im-pro-at/DIYPOV/README.md

# DIYPOV
 One POV Display to rule them all!
