im-pro-at/DIYPOV/3D/ezgif-3-e1404efcaa7f.gif

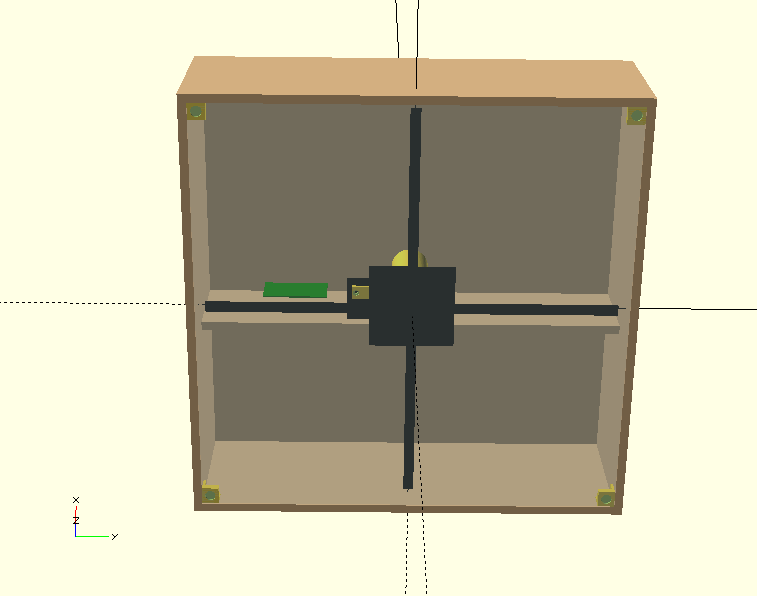
3D/ezgif-3-e1404efcaa7f.gif
