im-pro-at/DIYPOV/3D/drill_wood_500_100.pdf

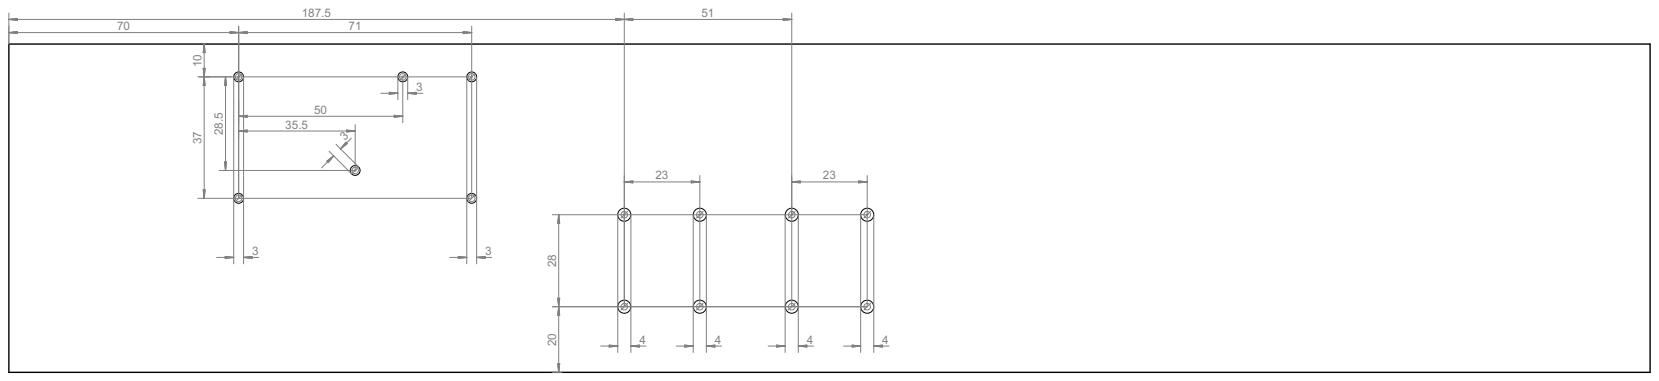
[picture p2: page 1]
