im-pro-at/DIYPOV/3D/drill_wood_500_500.pdf

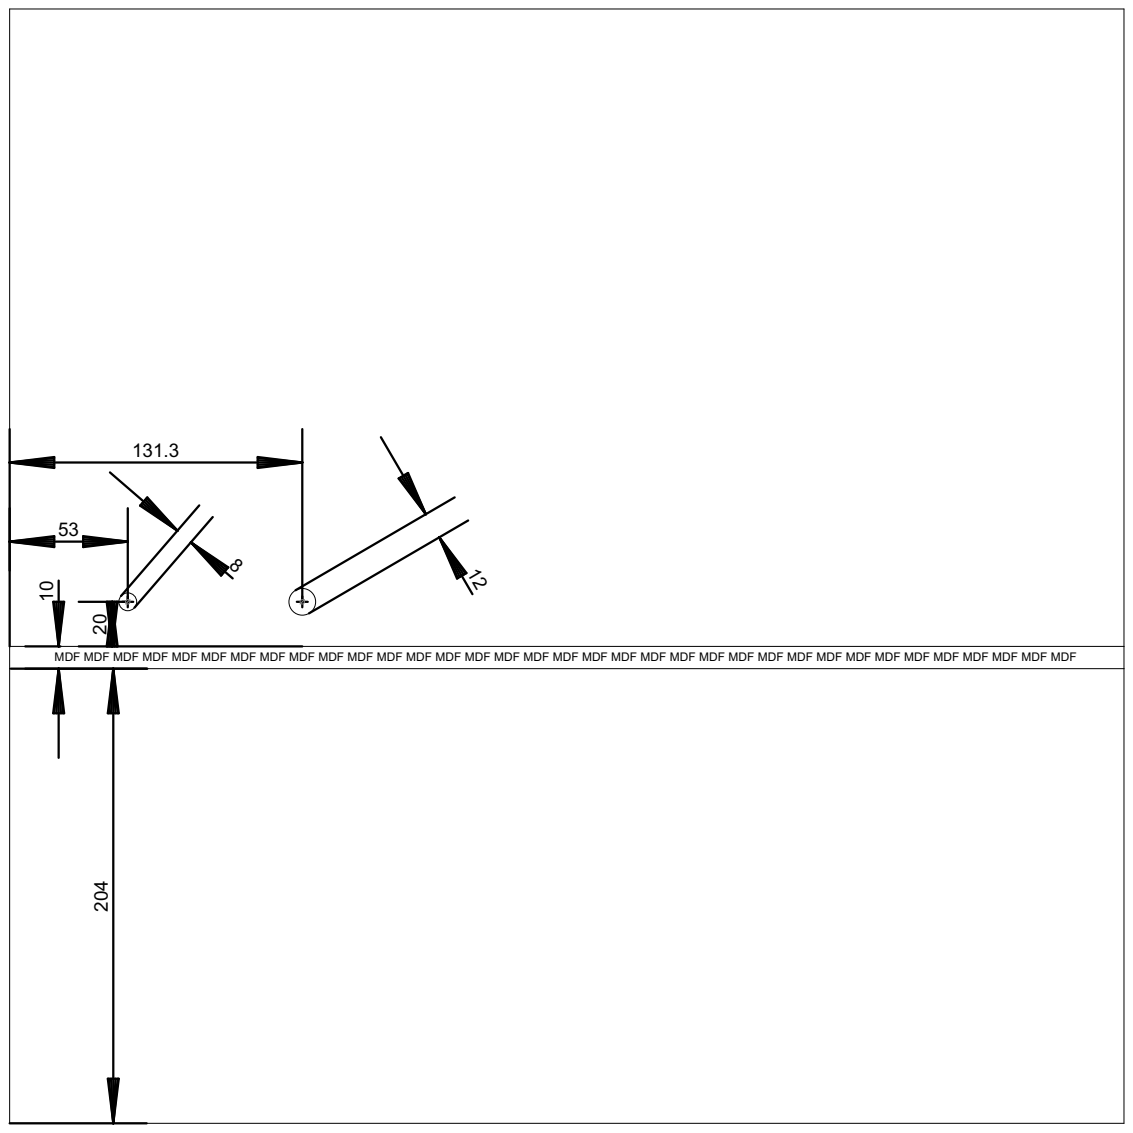
[picture p4: page 1]

MDF MDF MDF MDF MDF MDF MDF MDF MDF MDF MDF MDF MDF MDF MDF MDF MDF MDF MDF MDF MDF MDF MDF MDF MDF MDF MDF MDF MDF MDF MDF MDF MDF MDF MDF
