im-pro-at/DIYPOV/pcb/motor.brd

## EAGLE design pcb/motor.brd (2019-09-08)

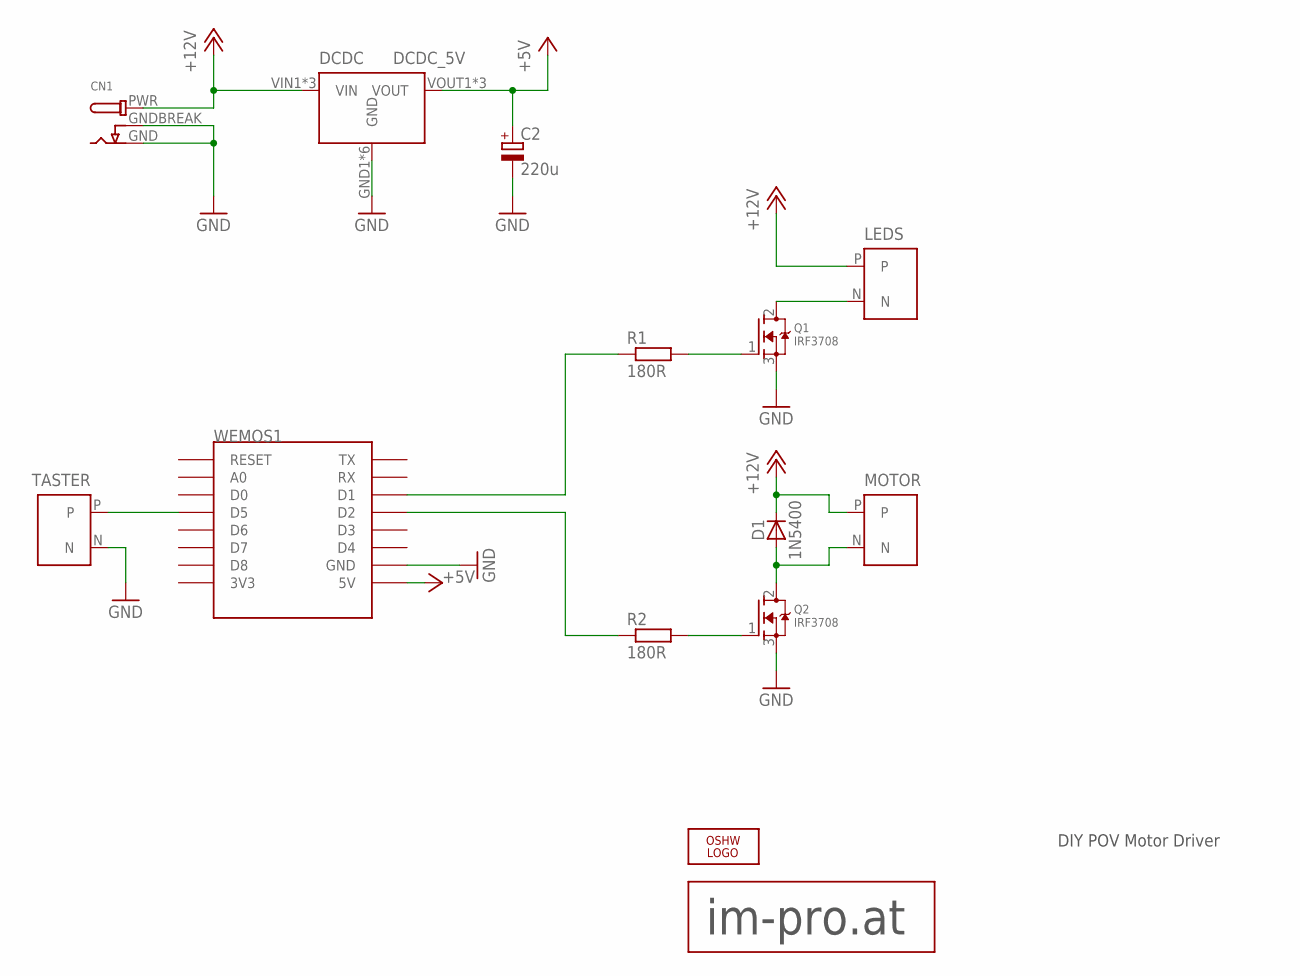
[picture p5: schematic motor.sch]

Parts:
C2: 220u; E3,5-8
CN1: DCBARRELPTH; DCJACK_2MM_PTH
D1: 1N5400; DO201-15
DCDC: DCDC_5V; DCDC
LEDS: TX30; XT30
LOGO1: OSHW_LOGO_FILLX0350-NT; OSHW_FILLX350_NOTEXT
MOTOR: TX30; XT30
Q1, Q2: IRF3708; TO220V
R1, R2: 180R; 0207/10
TASTER: TX30; XT30
U$1: LOGO20MM; LOGO_20MM
WEMOS1: WEMOS-D1-MINI

Connections:
+5V: C2.+, DCDC.VOUT1 (VOUT), DCDC.VOUT2 (VOUT), DCDC.VOUT3 (VOUT), WEMOS1.5V
+12V: CN1.PWR, D1.C, DCDC.VIN1 (VIN), DCDC.VIN2 (VIN), DCDC.VIN3 (VIN), LEDS.P, MOTOR.P
GND: C2.-, CN1.GND, CN1.GNDBREAK, DCDC.GND1 (GND), DCDC.GND2 (GND), DCDC.GND3 (GND), DCDC.GND4 (GND), DCDC.GND5 (GND), DCDC.GND6 (GND), Q1.3 (S), Q2.3 (S), TASTER.N, WEMOS1.GND
unnamed: D1.A, MOTOR.N, Q2.2 (D)
unnamed: LEDS.N, Q1.2 (D)
unnamed: R1.1, WEMOS1.D1
unnamed: TASTER.P, WEMOS1.D5
unnamed: R2.1, WEMOS1.D2
unnamed: Q2.1 (G), R2.2
unnamed: Q1.1 (G), R1.2

Notes on the sheet:
DIY POV Motor Driver

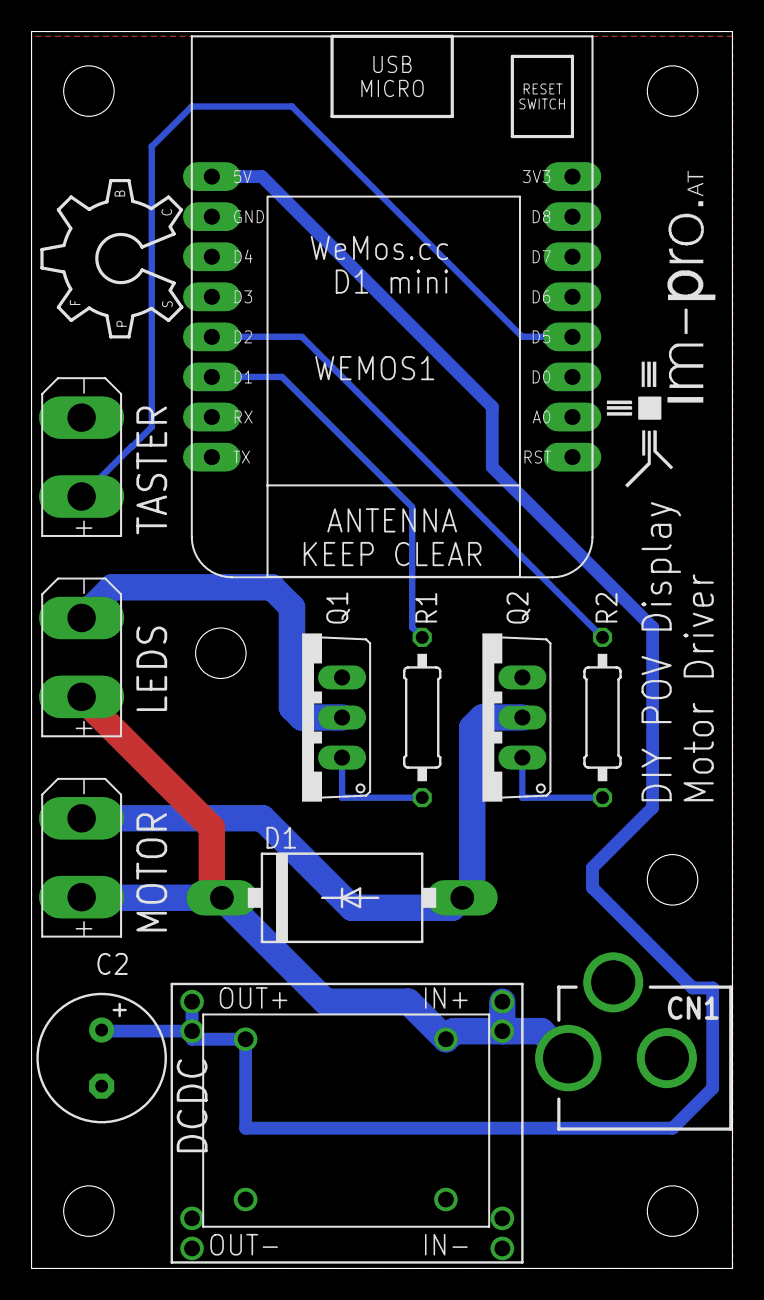
[picture p6: board motor.brd from above]

Board: 2 copper layers, 44.4 x 78.4 mm, 14 parts (0 on the bottom side), 10 nets.
