im-pro-at/DIYPOV/pcb/main.brd

## EAGLE design pcb/main.brd (2019-09-08)

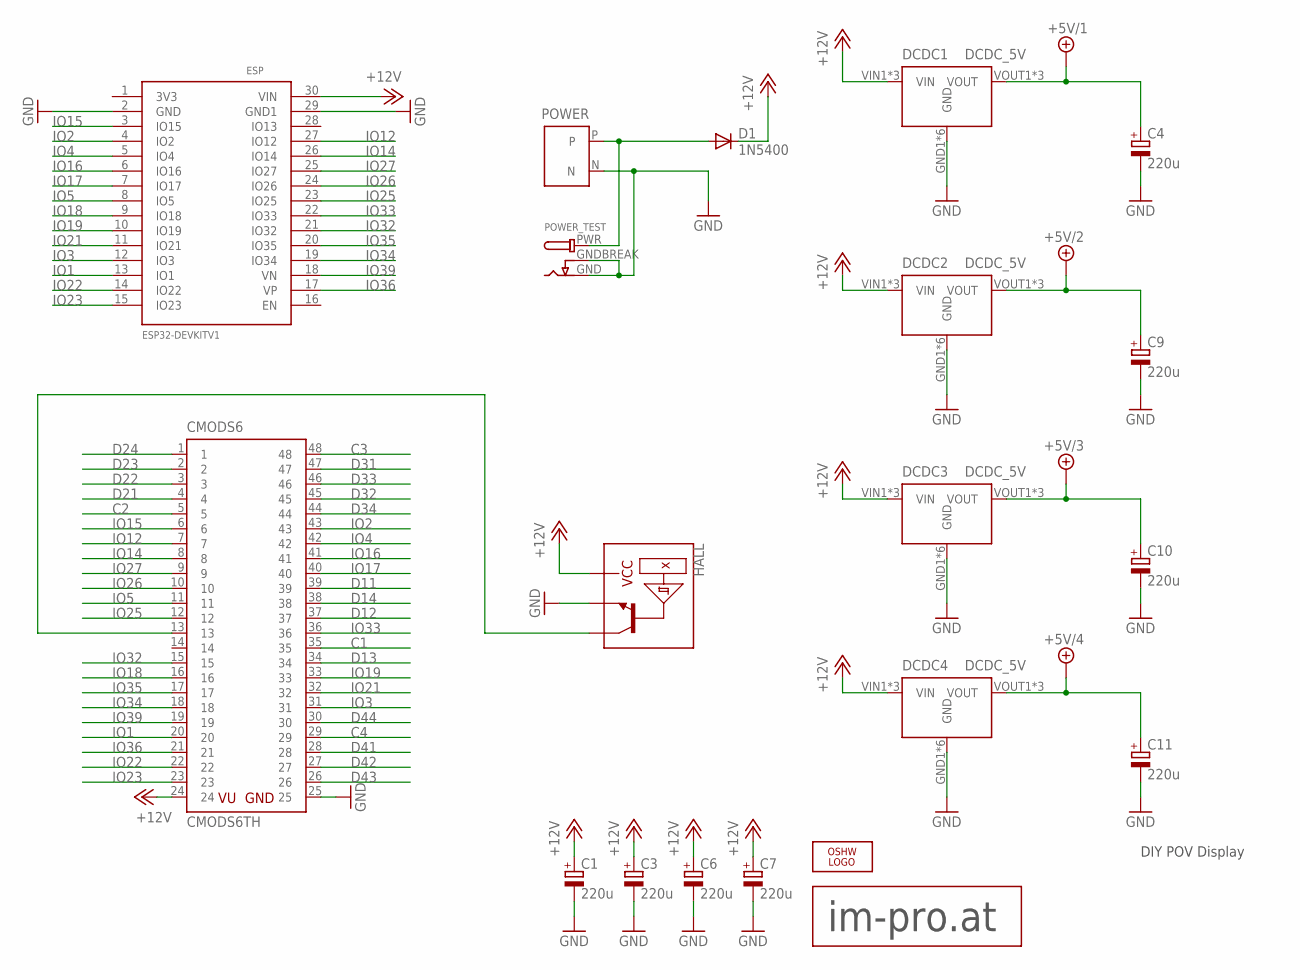
[picture p7: schematic main.sch, sheet 1]

Parts:
C1, C3, C4, C6, C7, C9, C10, C11: 220u; E3,5-8
CMODS6: CMODS6TH; DIL48
D1: 1N5400; DO201-15
DCDC1, DCDC2, DCDC3, DCDC4: DCDC_5V; DCDC
ESP: ESP32DEVKITV1; ESP32-DEVKITV1
HALL: HALL
LOGO1: OSHW_LOGO_FILLX0350-NT; OSHW_FILLX350_NOTEXT
POWER: TX30; XT30
POWER_TEST: DCBARRELPTH; DCJACK_2MM_PTH
U$2: LOGO20MM; LOGO_20MM

Connections:
+5V/1: C4.+, DCDC1.VOUT1 (VOUT), DCDC1.VOUT2 (VOUT), DCDC1.VOUT3 (VOUT); also elsewhere on the board
+5V/2: C9.+, DCDC2.VOUT1 (VOUT), DCDC2.VOUT2 (VOUT), DCDC2.VOUT3 (VOUT); also elsewhere on the board
+5V/3: C10.+, DCDC3.VOUT1 (VOUT), DCDC3.VOUT2 (VOUT), DCDC3.VOUT3 (VOUT); also elsewhere on the board
+5V/4: C11.+, DCDC4.VOUT1 (VOUT), DCDC4.VOUT2 (VOUT), DCDC4.VOUT3 (VOUT); also elsewhere on the board
+12V: C1.+, C3.+, C6.+, C7.+, CMODS6.24, D1.C, DCDC1.VIN1 (VIN), DCDC1.VIN2 (VIN), DCDC1.VIN3 (VIN), DCDC2.VIN1 (VIN), DCDC2.VIN2 (VIN), DCDC2.VIN3 (VIN), DCDC3.VIN1 (VIN), DCDC3.VIN2 (VIN), DCDC3.VIN3 (VIN), DCDC4.VIN1 (VIN), DCDC4.VIN2 (VIN), DCDC4.VIN3 (VIN), ESP.30 (VIN), HALL.VCC
C1: CMODS6.35; also elsewhere on the board
C2: CMODS6.5; also elsewhere on the board
C3: CMODS6.48; also elsewhere on the board
C4: CMODS6.29; also elsewhere on the board
D11: CMODS6.39; also elsewhere on the board
D12: CMODS6.37; also elsewhere on the board
D13: CMODS6.34; also elsewhere on the board
D14: CMODS6.38; also elsewhere on the board
D21: CMODS6.4; also elsewhere on the board
D22: CMODS6.3; also elsewhere on the board
D23: CMODS6.2; also elsewhere on the board
D24: CMODS6.1; also elsewhere on the board
D31: CMODS6.47; also elsewhere on the board
D32: CMODS6.45; also elsewhere on the board
D33: CMODS6.46; also elsewhere on the board
D34: CMODS6.44; also elsewhere on the board
D41: CMODS6.28; also elsewhere on the board
D42: CMODS6.27; also elsewhere on the board
D43: CMODS6.26; also elsewhere on the board
D44: CMODS6.30; also elsewhere on the board
GND: C1.-, C3.-, C4.-, C6.-, C7.-, C9.-, C10.-, C11.-, CMODS6.25, DCDC1.GND1 (GND), DCDC1.GND2 (GND), DCDC1.GND3 (GND), DCDC1.GND4 (GND), DCDC1.GND5 (GND), DCDC1.GND6 (GND), DCDC2.GND1 (GND), DCDC2.GND2 (GND), DCDC2.GND3 (GND), DCDC2.GND4 (GND), DCDC2.GND5 (GND), DCDC2.GND6 (GND), DCDC3.GND1 (GND), DCDC3.GND2 (GND), DCDC3.GND3 (GND), DCDC3.GND4 (GND), DCDC3.GND5 (GND), DCDC3.GND6 (GND), DCDC4.GND1 (GND), DCDC4.GND2 (GND), DCDC4.GND3 (GND), DCDC4.GND4 (GND), DCDC4.GND5 (GND), DCDC4.GND6 (GND), ESP.2 (GND), ESP.29 (GND1), HALL.GND, POWER.N, POWER_TEST.GND, POWER_TEST.GNDBREAK; also elsewhere on the board
IO1: CMODS6.20, ESP.13 (IO1)
IO2: CMODS6.43, ESP.4 (IO2)
IO3: CMODS6.31, ESP.12 (IO3)
IO4: CMODS6.42, ESP.5 (IO4)
IO5: CMODS6.11, ESP.8 (IO5)
IO12: CMODS6.7, ESP.27 (IO12)
IO14: CMODS6.8, ESP.26 (IO14)
IO15: CMODS6.6, ESP.3 (IO15)
IO16: CMODS6.41, ESP.6 (IO16)
IO17: CMODS6.40, ESP.7 (IO17)
IO18: CMODS6.16, ESP.9 (IO18)
IO19: CMODS6.33, ESP.10 (IO19)
IO21: CMODS6.32, ESP.11 (IO21)
IO22: CMODS6.22, ESP.14 (IO22)
IO23: CMODS6.23, ESP.15 (IO23)
IO25: CMODS6.12, ESP.23 (IO25)
IO26: CMODS6.10, ESP.24 (IO26)
IO27: CMODS6.9, ESP.25 (IO27)
IO32: CMODS6.15, ESP.21 (IO32)
IO33: CMODS6.36, ESP.22 (IO33)
IO34: CMODS6.18, ESP.19 (IO34)
IO35: CMODS6.17, ESP.20 (IO35)
IO36: CMODS6.21, ESP.17 (VP)
IO39: CMODS6.19, ESP.18 (VN)
unnamed: CMODS6.13, HALL.OUT
unnamed: D1.A, POWER.P, POWER_TEST.PWR

Notes on the sheet:
DIY POV Display

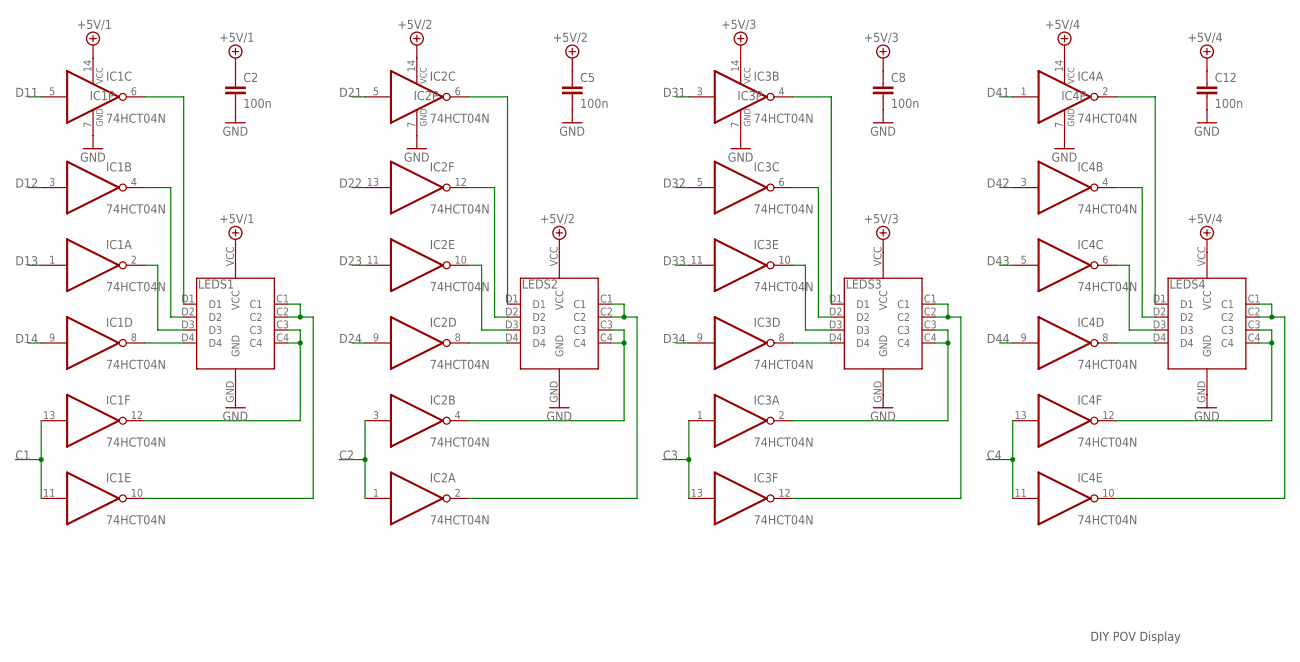
[picture p8: schematic main.sch, sheet 2]

Parts:
C2, C5, C8, C12: 100n; C025_050-025X075
IC1, IC2, IC3, IC4: 74HCT04N; DIL14
LEDS1, LEDS2, LEDS3, LEDS4: LEDCON

Connections:
+5V/1: C2.1, IC1.14 (VCC), LEDS1.VCC; also elsewhere on the board
+5V/2: C5.1, IC2.14 (VCC), LEDS2.VCC; also elsewhere on the board
+5V/3: C8.1, IC3.14 (VCC), LEDS3.VCC; also elsewhere on the board
+5V/4: C12.1, IC4.14 (VCC), LEDS4.VCC; also elsewhere on the board
C1: IC1.11 (I), IC1.13 (I); also elsewhere on the board
C2: IC2.1 (I), IC2.3 (I); also elsewhere on the board
C3: IC3.1 (I), IC3.13 (I); also elsewhere on the board
C4: IC4.11 (I), IC4.13 (I); also elsewhere on the board
D11: IC1.5 (I); also elsewhere on the board
D12: IC1.3 (I); also elsewhere on the board
D13: IC1.1 (I); also elsewhere on the board
D14: IC1.9 (I); also elsewhere on the board
D21: IC2.5 (I); also elsewhere on the board
D22: IC2.13 (I); also elsewhere on the board
D23: IC2.11 (I); also elsewhere on the board
D24: IC2.9 (I); also elsewhere on the board
D31: IC3.3 (I); also elsewhere on the board
D32: IC3.5 (I); also elsewhere on the board
D33: IC3.11 (I); also elsewhere on the board
D34: IC3.9 (I); also elsewhere on the board
D41: IC4.1 (I); also elsewhere on the board
D42: IC4.3 (I); also elsewhere on the board
D43: IC4.5 (I); also elsewhere on the board
D44: IC4.9 (I); also elsewhere on the board
GND: C2.2, C2.3 (2), C5.2, C5.3 (2), C8.2, C8.3 (2), C12.2, C12.3 (2), IC1.7 (GND), IC2.7 (GND), IC3.7 (GND), IC4.7 (GND), LEDS1.GND, LEDS2.GND, LEDS3.GND, LEDS4.GND; also elsewhere on the board
unnamed: IC1.8 (O), LEDS1.D4
unnamed: IC1.2 (O), LEDS1.D3
unnamed: IC1.4 (O), LEDS1.D2
unnamed: IC1.6 (O), LEDS1.D1
unnamed: IC1.12 (O), LEDS1.C3, LEDS1.C4
unnamed: IC1.10 (O), LEDS1.C1, LEDS1.C2
unnamed: IC2.8 (O), LEDS2.D4
unnamed: IC2.10 (O), LEDS2.D3
unnamed: IC2.12 (O), LEDS2.D2
unnamed: IC2.6 (O), LEDS2.D1
unnamed: IC2.4 (O), LEDS2.C3, LEDS2.C4
unnamed: IC2.2 (O), LEDS2.C1, LEDS2.C2
unnamed: IC3.8 (O), LEDS3.D4
unnamed: IC3.10 (O), LEDS3.D3
unnamed: IC3.6 (O), LEDS3.D2
unnamed: IC3.4 (O), LEDS3.D1
unnamed: IC3.2 (O), LEDS3.C3, LEDS3.C4
unnamed: IC3.12 (O), LEDS3.C1, LEDS3.C2
unnamed: IC4.8 (O), LEDS4.D4
unnamed: IC4.6 (O), LEDS4.D3
unnamed: IC4.4 (O), LEDS4.D2
unnamed: IC4.2 (O), LEDS4.D1
unnamed: IC4.12 (O), LEDS4.C3, LEDS4.C4
unnamed: IC4.10 (O), LEDS4.C1, LEDS4.C2

Notes on the sheet:
DIY POV Display

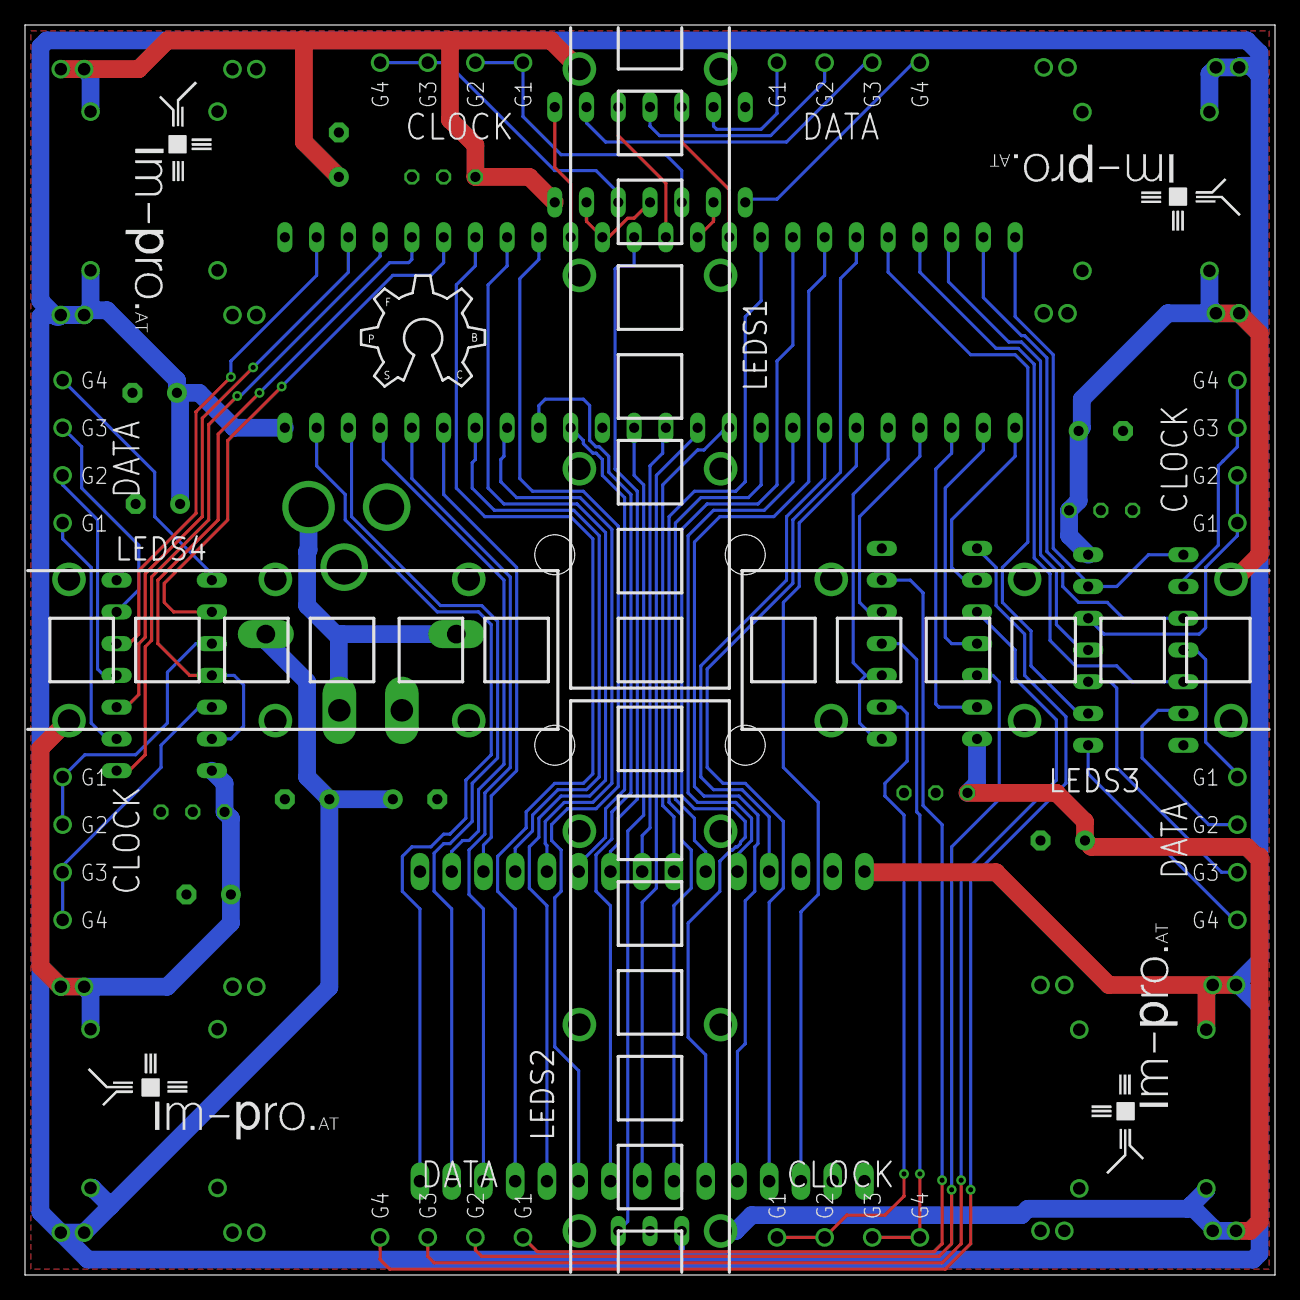
[picture p9: board main.brd from above]

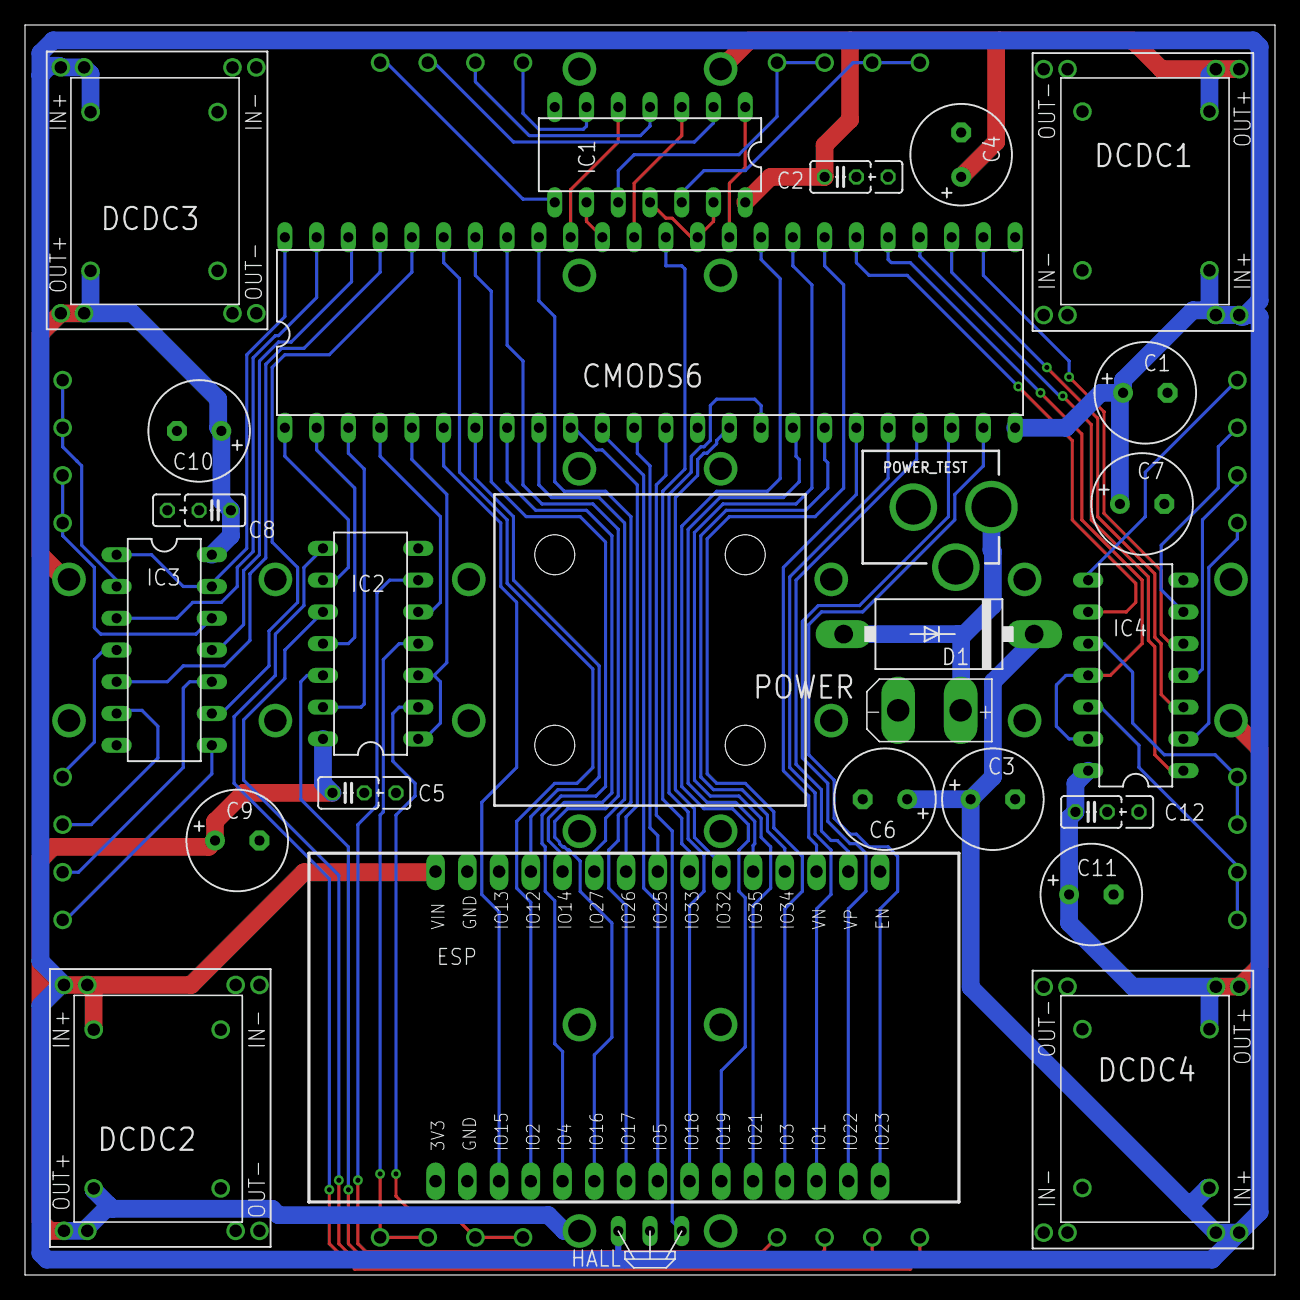
[picture p10: board main.brd from below]

Board: 2 copper layers, 100.0 x 100.0 mm, 35 parts (26 on the bottom side), 76 nets.

Other parts of the board:
U$1, U$3, U$4: LOGO20MM; LOGO_20MM
