im-pro-at/DIYPOV/arduino/povdisplay/i2s_parallel.c

// Copyright 2017 Espressif Systems (Shanghai) PTE LTD
//
// Licensed under the Apache License, Version 2.0 (the "License");
// you may not use this file except in compliance with the License.
// You may obtain a copy of the License at
//
//     http://www.apache.org/licenses/LICENSE-2.0
//
// Unless required by applicable law or agreed to in writing, software
// distributed under the License is distributed on an "AS IS" BASIS,
// WITHOUT WARRANTIES OR CONDITIONS OF ANY KIND, either express or implied.
// See the License for the specific language governing permissions and
// limitations under the License.

// modified for 8bit lcd mode with encoded Hsync and Vsync pulses,
// double buffered frame  HN

#include "common.h"

#include "soc/i2s_struct.h"
#include "soc/i2s_reg.h"
#include "driver/periph_ctrl.h"
#include "soc/io_mux_reg.h"
#include "rom/lldesc.h"
#include "esp_heap_caps.h"
#include "i2s_parallel.h"

#define TAG "i2s_parallel"

#ifdef DOUBLE_BUFFERED
   typedef struct {
      volatile lldesc_t* dmadesc_a;
	   volatile lldesc_t* dmadesc_b;
      int desccount_a;
	   int desccount_b;
   } i2s_parallel_state_t;
#else
   typedef struct {
      volatile lldesc_t* dmadesc;
      int desccount;
   } i2s_parallel_state_t;
#endif

static i2s_parallel_state_t* i2s_state[2] = {NULL, NULL};

#define DMA_MAX (4096-4)

//Calculate the amount of dma descs needed for a buffer desc
static int calc_needed_dma_descs_for(i2s_parallel_buffer_desc_t *desc) {
   int ret = (desc->size + DMA_MAX - 1)/DMA_MAX;
   return ret;
	}

static void fill_dma_desc(volatile lldesc_t* dmadesc, i2s_parallel_buffer_desc_t* bufdesc) {
   int n = 0;
   int len = bufdesc->size;
   uint8_t* data = (uint8_t*)bufdesc->memory;
   while(len) {
		int dmalen = len;
		if (dmalen > DMA_MAX) dmalen = DMA_MAX;
		dmadesc[n].size = dmalen;
		dmadesc[n].length = dmalen;
		dmadesc[n].buf = data;
		dmadesc[n].eof = 0;
		dmadesc[n].sosf = 0;
		dmadesc[n].owner = 1;
		dmadesc[n].qe.stqe_next = (lldesc_t*)&dmadesc[n+1];
		dmadesc[n].offset = 0;
		len -= dmalen;
		data += dmalen;
		n++;
		}
   //Loop last back to first
   dmadesc[n-1].qe.stqe_next = (lldesc_t*)&dmadesc[0];
   ESP_LOGI(TAG,"fill_dma_desc: filled %d descriptors\n", n);
   }

static void gpio_setup_out(int gpio, int sig, int inv) {
    if (gpio == -1) return;
    PIN_FUNC_SELECT(GPIO_PIN_MUX_REG[gpio], PIN_FUNC_GPIO);
    gpio_set_direction(gpio, GPIO_MODE_DEF_OUTPUT);
    gpio_matrix_out(gpio, sig, inv, false);
	}


static void dma_reset(i2s_dev_t *dev) {
    dev->lc_conf.in_rst=1; 
	dev->lc_conf.in_rst=0;
    dev->lc_conf.out_rst=1; 
	dev->lc_conf.out_rst=0;
	}

static void fifo_reset(i2s_dev_t *dev) {
    dev->conf.rx_fifo_reset=1; 
	dev->conf.rx_fifo_reset=0;
    dev->conf.tx_fifo_reset=1; 
	dev->conf.tx_fifo_reset=0;
	}

static int i2snum(i2s_dev_t *dev) {
    return (dev == &I2S0)? 0 : 1;
	}

void i2s_parallel_setup(i2s_dev_t *dev, const i2s_parallel_config_t *cfg) {
    //Figure out which signal numbers to use for routing
    ESP_LOGI(TAG,"Setting up parallel I2S bus at I2S%d\n", i2snum(dev));
    int sig_data_base, sig_clk;
    if (dev == &I2S0) {
        sig_data_base = I2S0O_DATA_OUT0_IDX;
        sig_clk = I2S0O_WS_OUT_IDX;
		} 
	else {
        if (cfg->bits == I2S_PARALLEL_BITS_32 ) {
            sig_data_base = I2S1O_DATA_OUT0_IDX;
			} 
		else 
        if (cfg->bits == I2S_PARALLEL_BITS_8 ) {
            sig_data_base = I2S1O_DATA_OUT0_IDX;
			} 
		else {
            //Because of... reasons... the 16-bit values for i2s1 appear on d8...d23
            sig_data_base = I2S1O_DATA_OUT8_IDX;
			}
        sig_clk = I2S1O_WS_OUT_IDX;
		}
    
    //Route the signals
    for(int i=0;i<12+1;i++){
      //if(cfg->gpio_bus[i]!=-1 && cfg->gpio_bus[i]!=0)
        gpio_setup_out(cfg->gpio_bus[i], sig_data_base+i, false);      
    }
		
    //ToDo: Clk/WS may need inversion?
    //gpio_setup_out(cfg->gpio_clk, sig_clk, true);
    gpio_setup_out(cfg->gpio_clk, sig_clk, false);
    
    //Power on dev
    if (dev == &I2S0) {
        periph_module_enable(PERIPH_I2S0_MODULE);
		} 
	else {
        periph_module_enable(PERIPH_I2S1_MODULE);
		}
    //Initialize I2S dev
    dev->conf.rx_reset = 1; 
	dev->conf.rx_reset = 0;
    dev->conf.tx_reset = 1; 
	dev->conf.tx_reset = 0;
    dma_reset(dev);
    fifo_reset(dev);
    
    //Enable LCD mode
    dev->conf2.val = 0;
    dev->conf2.lcd_en = 1;
    dev->conf2.lcd_tx_wrx2_en = 0; // HN
    dev->conf2.lcd_tx_sdx2_en = 0; // HN
    
    dev->sample_rate_conf.val = 0;
    dev->sample_rate_conf.rx_bits_mod = cfg->bits;
    dev->sample_rate_conf.tx_bits_mod = cfg->bits;
    dev->sample_rate_conf.rx_bck_div_num = 4; //ToDo: Unsure about what this does...
    dev->sample_rate_conf.tx_bck_div_num = 4;
    
    dev->clkm_conf.val = 0;
    dev->clkm_conf.clka_en = 0;
    dev->clkm_conf.clkm_div_a = 63;
    dev->clkm_conf.clkm_div_b = 63;
    //We ignore the possibility for fractional division here.
    dev->clkm_conf.clkm_div_num = 80000000L/cfg->clkspeed_hz;
    
    dev->fifo_conf.val = 0;
    dev->fifo_conf.rx_fifo_mod_force_en = 1; 
    dev->fifo_conf.tx_fifo_mod_force_en = 1; // HN
    dev->fifo_conf.tx_fifo_mod = 1; // HN
    dev->fifo_conf.tx_fifo_mod = 1;
    dev->fifo_conf.rx_data_num = 32; //Thresholds. 
    dev->fifo_conf.tx_data_num = 32;
    dev->fifo_conf.dscr_en = 1;
	
	
    
    dev->conf1.val = 0;
    dev->conf1.tx_stop_en = 0;
    dev->conf1.tx_pcm_bypass = 1;
    
    dev->conf_chan.val = 0;
    dev->conf_chan.tx_chan_mod = 1; // HN
    dev->conf_chan.rx_chan_mod = 1;
    
    //Invert ws to be active-low... ToDo: make this configurable
    dev->conf.tx_right_first = 1;
    dev->conf.rx_right_first = 1;
    
    dev->timing.val = 0;
    
    //Allocate DMA descriptors
    i2s_state[i2snum(dev)] = malloc(sizeof(i2s_parallel_state_t));
    i2s_parallel_state_t *st = i2s_state[i2snum(dev)];
#ifdef DOUBLE_BUFFERED
    st->desccount_a = calc_needed_dma_descs_for(cfg->bufa);
	 ESP_LOGI(TAG,"st->descccount_a = %d\r\n", st->desccount_a);
    st->desccount_b = calc_needed_dma_descs_for(cfg->bufb);
	 ESP_LOGI(TAG,"st->descccount_b = %d\r\n", st->desccount_b);
    st->dmadesc_a = heap_caps_malloc(st->desccount_a*sizeof(lldesc_t), MALLOC_CAP_DMA);
    st->dmadesc_b = heap_caps_malloc(st->desccount_b*sizeof(lldesc_t), MALLOC_CAP_DMA);    
    //and fill them
    fill_dma_desc(st->dmadesc_a, cfg->bufa);
    fill_dma_desc(st->dmadesc_b, cfg->bufb);
#else
    st->desccount = calc_needed_dma_descs_for(cfg->buf);
	 ESP_LOGI(TAG,"st->descccount = %d\r\n", st->desccount);
    st->dmadesc = heap_caps_malloc(st->desccount*sizeof(lldesc_t), MALLOC_CAP_DMA);
    //and fill them
    fill_dma_desc(st->dmadesc, cfg->buf);
#endif    

    //Reset FIFO/DMA -> needed? Doesn't dma_reset/fifo_reset do this?
    dev->lc_conf.in_rst = 1; 
	dev->lc_conf.out_rst = 1; 
	dev->lc_conf.ahbm_rst = 1; 
	dev->lc_conf.ahbm_fifo_rst = 1;
    dev->lc_conf.in_rst = 0; 
	dev->lc_conf.out_rst = 0; 
	dev->lc_conf.ahbm_rst = 0; 
	dev->lc_conf.ahbm_fifo_rst = 0;
    dev->conf.tx_reset = 1; 
	dev->conf.tx_fifo_reset = 1; 
	dev->conf.rx_fifo_reset = 1;
    dev->conf.tx_reset = 0; 
	dev->conf.tx_fifo_reset = 0; 
	dev->conf.rx_fifo_reset = 0;
    
    //Start dma on front buffer
    dev->lc_conf.val = I2S_OUT_DATA_BURST_EN | I2S_OUTDSCR_BURST_EN | I2S_OUT_DATA_BURST_EN;
#ifdef DOUBLE_BUFFERED
    dev->out_link.addr = ((uint32_t)(&st->dmadesc_a[0]));
#else
    dev->out_link.addr = ((uint32_t)(&st->dmadesc[0]));
#endif
    dev->out_link.start = 1;
    dev->conf.tx_start = 1;
	}


#ifdef DOUBLE_BUFFERED

//Flip to a buffer: 0 for bufa, 1 for bufb
void i2s_parallel_flip_to_buffer(i2s_dev_t *dev, int bufid) {
    int no=i2snum(dev);
    if (i2s_state[no]==NULL) return;
    lldesc_t *active_dma_chain;
    if (bufid==0) {
        active_dma_chain=(lldesc_t*)&i2s_state[no]->dmadesc_a[0];
    } else {
        active_dma_chain=(lldesc_t*)&i2s_state[no]->dmadesc_b[0];
    }

    i2s_state[no]->dmadesc_a[i2s_state[no]->desccount_a-1].qe.stqe_next=active_dma_chain;
    i2s_state[no]->dmadesc_b[i2s_state[no]->desccount_b-1].qe.stqe_next=active_dma_chain;
}

#endif
