im-pro-at/DIYPOV/(commit log)

2019-08-28 Initial commit: Copied data from POV project
    [brush.scad, config.scad, corner.scad, holder.scad, magnete.scad, main.brd, main.scad, main.sch]
2019-08-28 Add first changes to the 3D design
    [magnete.scad, main.scad]
2019-08-31 updated schematic for main board
    [main.brd, main.scad, main.sch]
2019-09-01 updated schematic for motor driver
    [main.brd, main.sch, motor.brd, motor.sch]
2019-09-05 first version of motor driver pcb layout
    [main.brd, main.sch, motor.brd, motor.sch]
2019-09-06 started layout of main pcb
    [main.brd, main.scad, main.sch]
2019-09-07 first version layout main pcb
    [main.brd, main.sch]
2019-09-07 finished main pcb layout
    [main.brd, main.sch, motor.brd, motor.sch]
2019-09-08 layout finished
    [main.brd, main.sch, motor.brd, motor.sch]
2019-09-11 started to implement arduino code for the ESP32
2019-09-19 3D design update
    [brush.scad, holder.scad, main.scad, motor.scad, pcb.scad]
2019-09-21 finished 3D model
    [brush.scad, drill_wood_500_100.brd, drill_wood_500_500.brd, main.scad]
2019-09-25 First useful version of ESP32 Firmware
    [drill_wood_500_500.brd]
2019-09-29 first functional release
    [drill_wood_500_100.brd]
